fritzkeyzer/WA-RemotePump/rf-nano.jpg

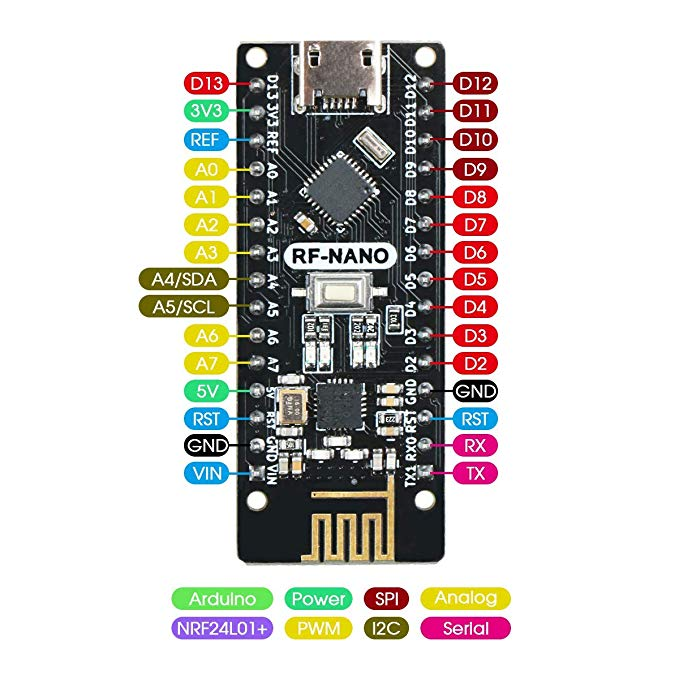
rf-nano.jpg
