fritzkeyzer/WA-RemotePump/README.md

# RemotePump
Remote pump controller project. Microcontroller source code
