fritzkeyzer/WA-RemotePump/v2.1 Schematic.pdf

## GND

## MEGA 2560

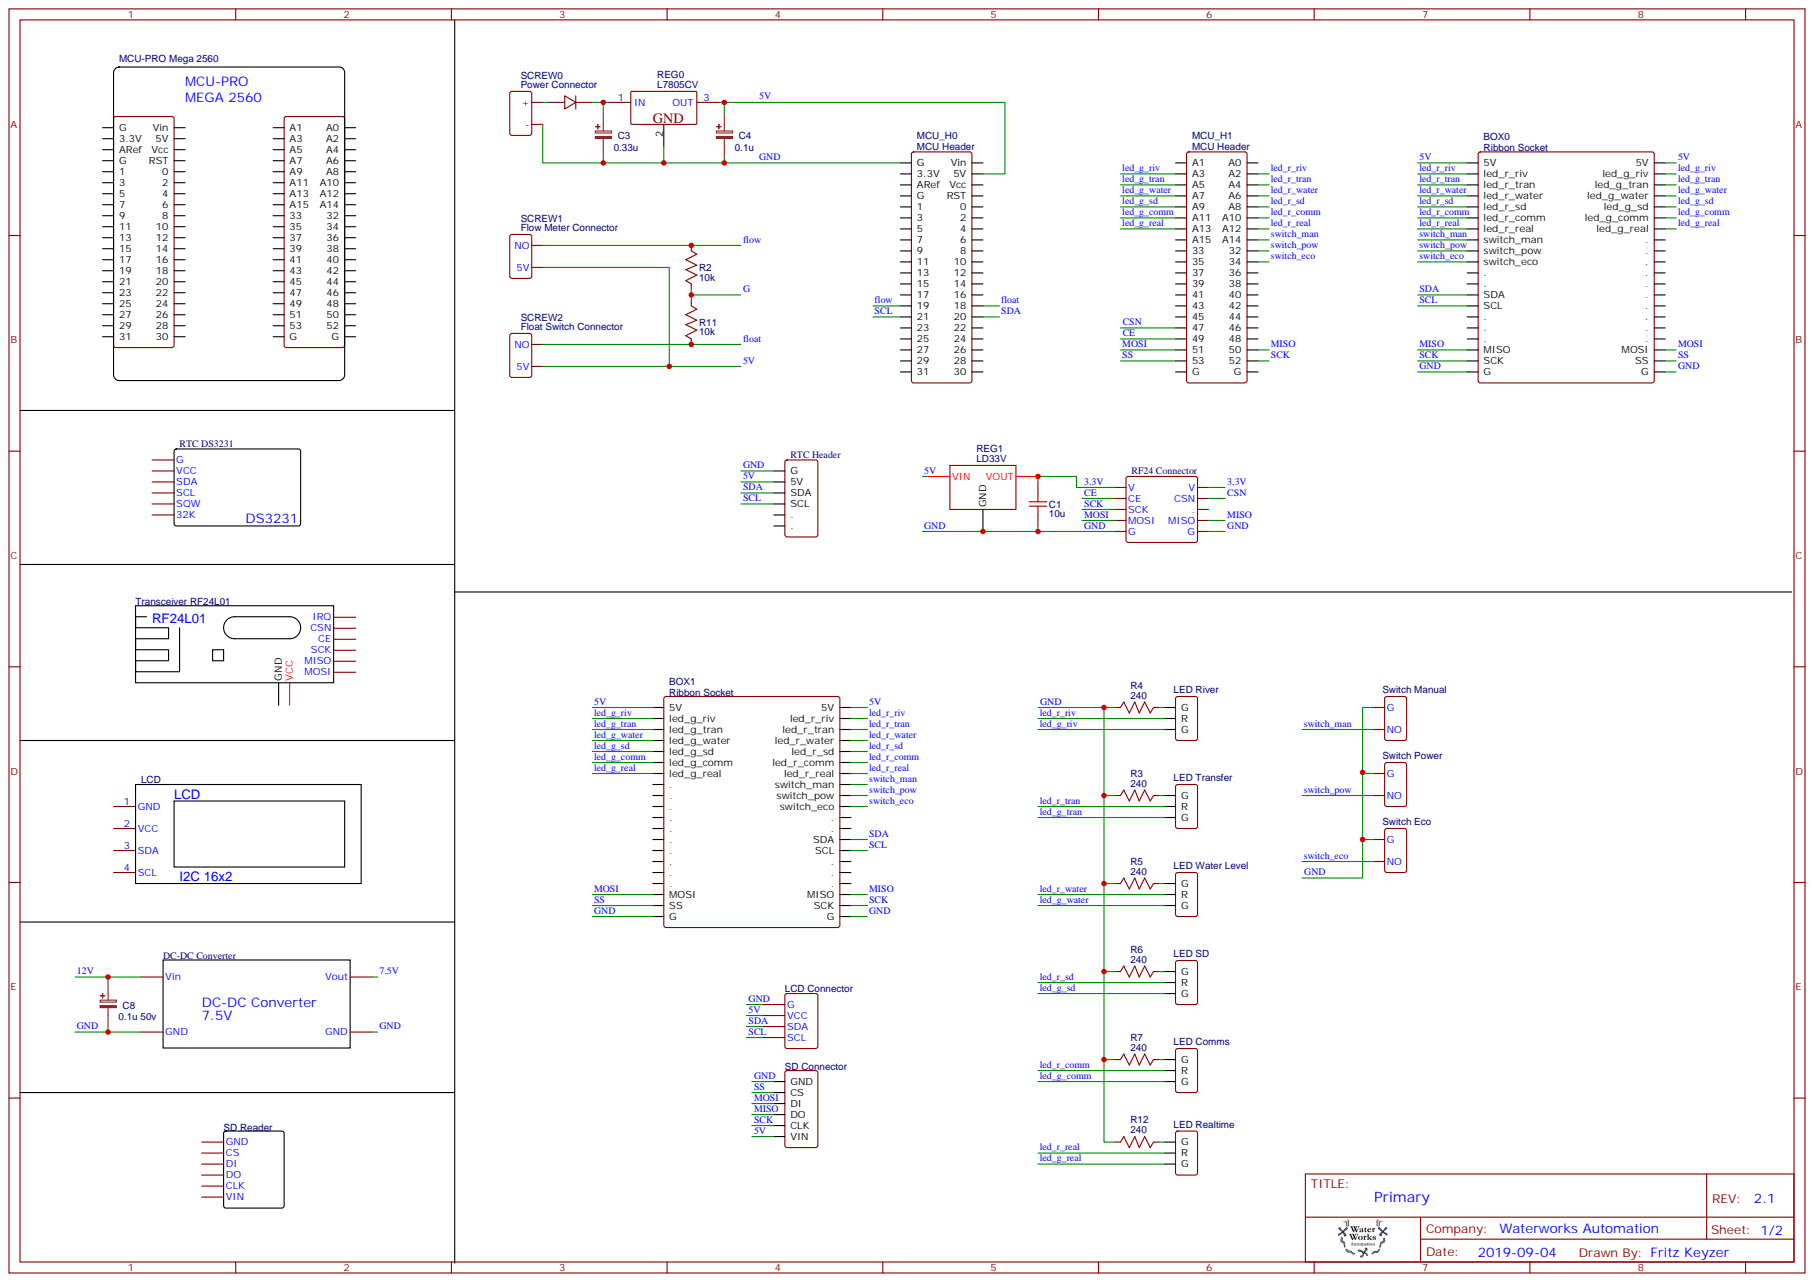
[picture p11: page 1]

Drawn By: Fritz Keyzer

## GND

## RF24L01

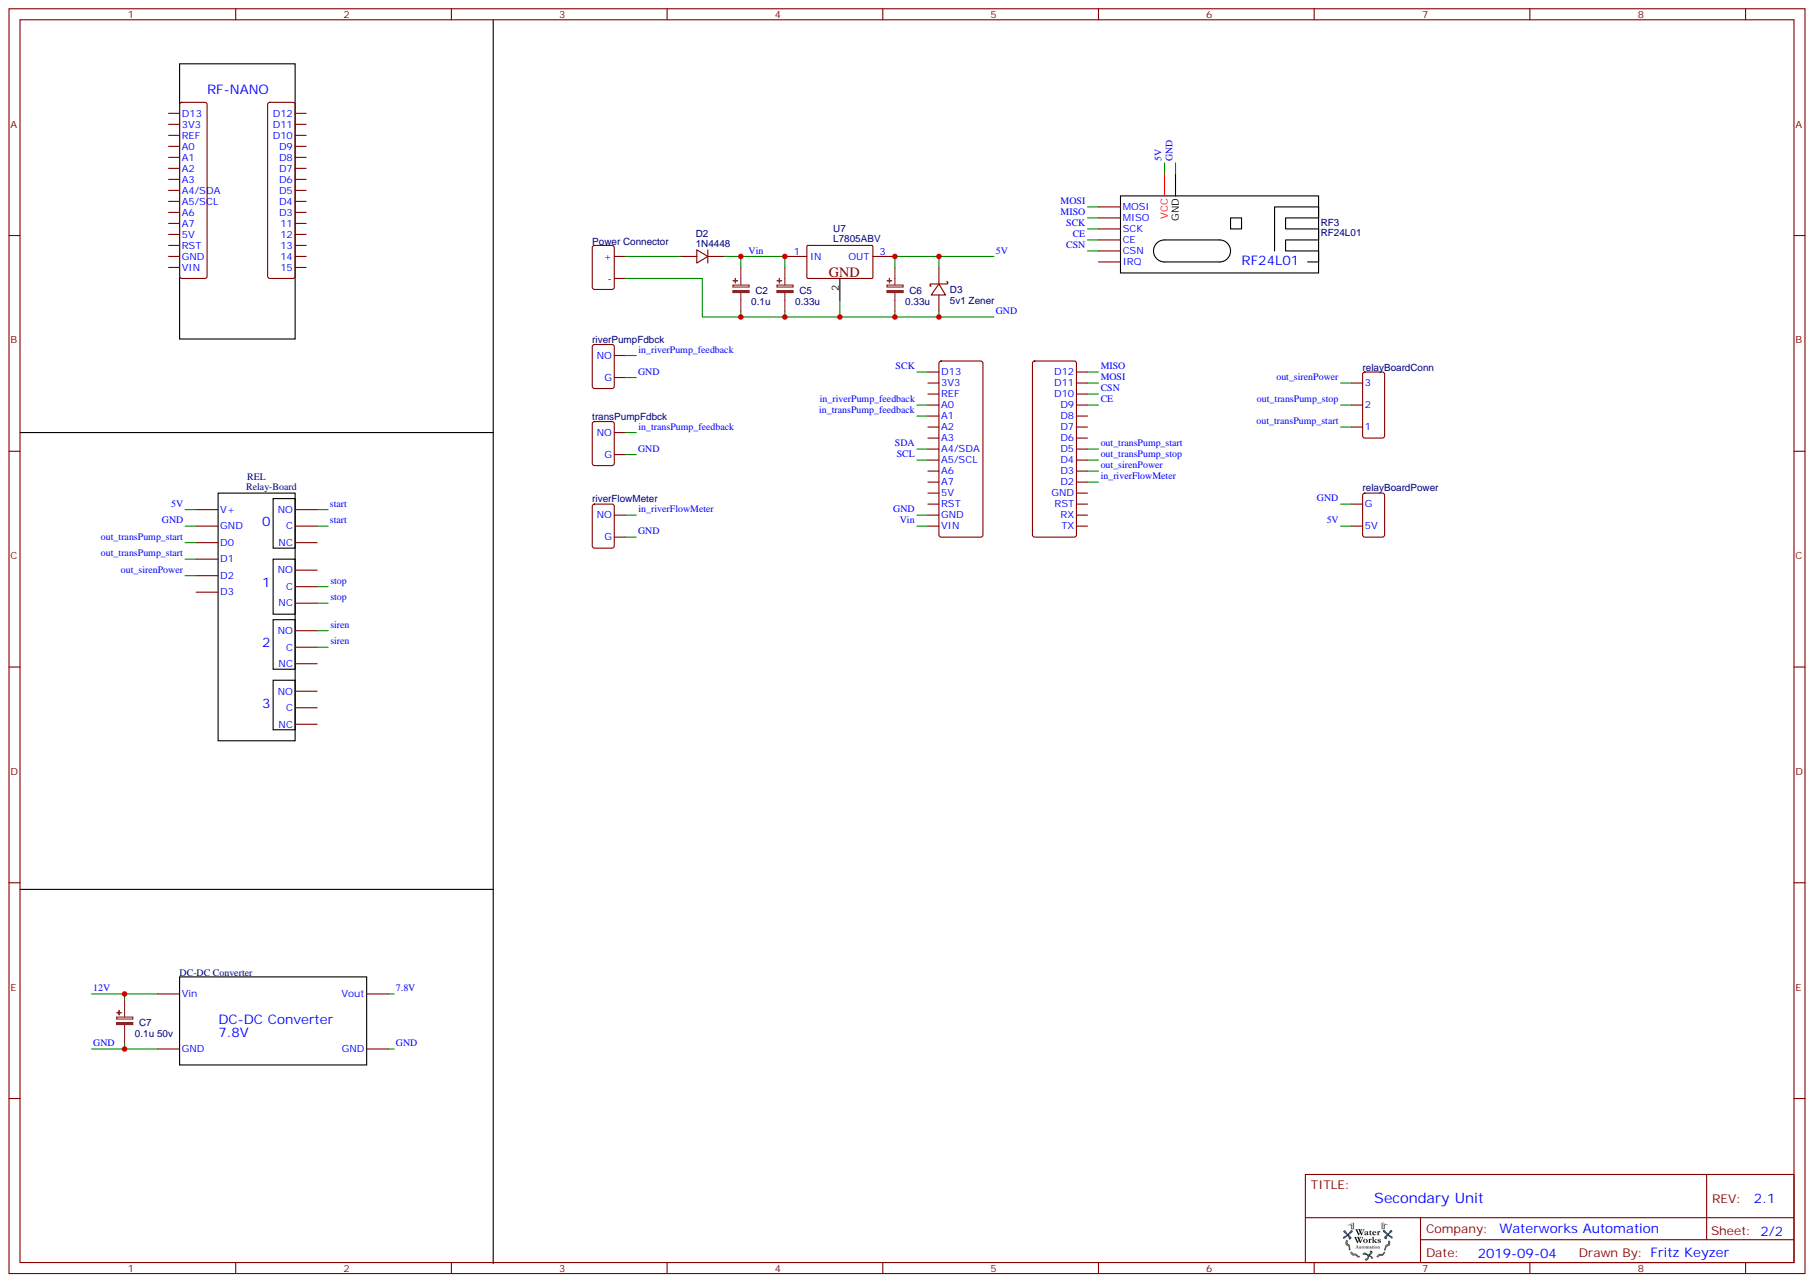
[picture p12: page 2]

Drawn By: Fritz Keyzer
