fritzkeyzer/WA-RemotePump/(commit log)

2019-07-03 new state machines, new comms - better error handling, new screens, event codes updated
    [ClockManager.ino, CommsManager.ino, DisplayManager.ino, EventManager.ino, IOManager.ino, PumpManager.ino]
2019-07-04 power cycle handling, eco mode fix, included startup states in event log
    [CommsManager.ino, EventManager.ino, PumpManager.ino]
2019-07-06 final commit - comms state unknown bug, added transmitting/receiving led, pin changes
    [ClockManager.ino, CommsManager.ino, DisplayManager.ino, EventManager.ino, IOManager.ino]
2019-07-06 pump status LED to switch off when status is unknown
2019-07-17 dropped rate from 2Mbps to 250Kbps... thats 8x slower... - this should reduce packet loss massively
    increase primary comm error time from 10s to 30s.
    - logs showed that quartile 3 error duration was 20s
    - 90th percentile error duration was 33s
    - 95th percentile error duration was 50s
    - for safety we can increase error time to 60s. - This would prevent 95% of all logged errors
    secondary comm error time remains 125s
    increase polling rate, by decreasing polling interval - from every 5s to every 2.5s - this should decrease errors by half in theory
    60s / 2.5s = 24 packets
    120s / 24 packets = 5s
    increase polling rate from primary, from every 10s to every 5s - this i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
    [CommsManager.ino, Secondary.ino]
2019-07-17 Revert "dropped rate from 2Mbps to 250Kbps... thats 8x slower... - this should reduce packet loss massively"
    This reverts commit fb94d630ff8b2d078b931af14a35d5de477040c1.
    [CommsManager.ino, Secondary.ino]
2019-07-17 example log file
    [LOG.CSV]
2019-07-17 Fixing comm errors
    dropped rate from 2Mbps to 250Kbps... thats 8x slower... - this should reduce packet loss massively
    increase primary comm error time from 10s to 60s.
    increase polling rate from primary, from every 10s to every 5s - this is a theoretical halv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
    [CommsManager.ino, Secondary.ino]
2019-07-17 Reorganised
    - renamed Primary unit sketch to "Primary"
    - deleted previous versions from repo, they can be found in commit history...
    - added "libraries" folder that contains a copy of all custom libraries that are used in the current version of the project.
2019-08-20 Version 2
    - Primary unit now logs water volume.
    - Secondary unit now monitors water flow rate and sets off an alarm if the flow rate is too low.
    [ClockManager.ino, CommsManager.ino, DisplayManager.ino, EventManager.ino, IOManager.ino, Primary.ino, PumpManager.ino]
2019-09-04 Version 2.1
    - Changed pump feedback inputs from NO to NC
    - Changed secondary to start with comms_error = true (preventing alarms)
    - Primary CommsStatus LED only shows a colour after, comms RX or comms Error. Shows blank until then.
2019-11-12 Flow meter settings
    Flow meter -> 100 litres per pulse
    lowflowThreshhold -> 1000 litres per hour
    timer_lowflowDelay -> 5 mins
2019-11-13 v2.12
    - timer lowflow thresh -> 1 min
2019-11-19 corrected flow rate calculation to include flow_volumePerTick variable
    [IOManager.ino]
2020-03-09 v3
    - comms error fix: randomized poll interval to avoid phasing
    - comms error timeout: 5 mins
    - Primary Unit Realtime Comms LED: actually works now - red blip for tx and green blip for rx
    [CommsManager.ino, IOManager.ino, Primary.ino, Secondary.ino]
